AdamV3D/ble_stepper_motor_analyser/kicad/stepper_monitor.kicad_pcb

## KiCad design kicad/stepper_monitor.kicad_pcb (2025-02-03)

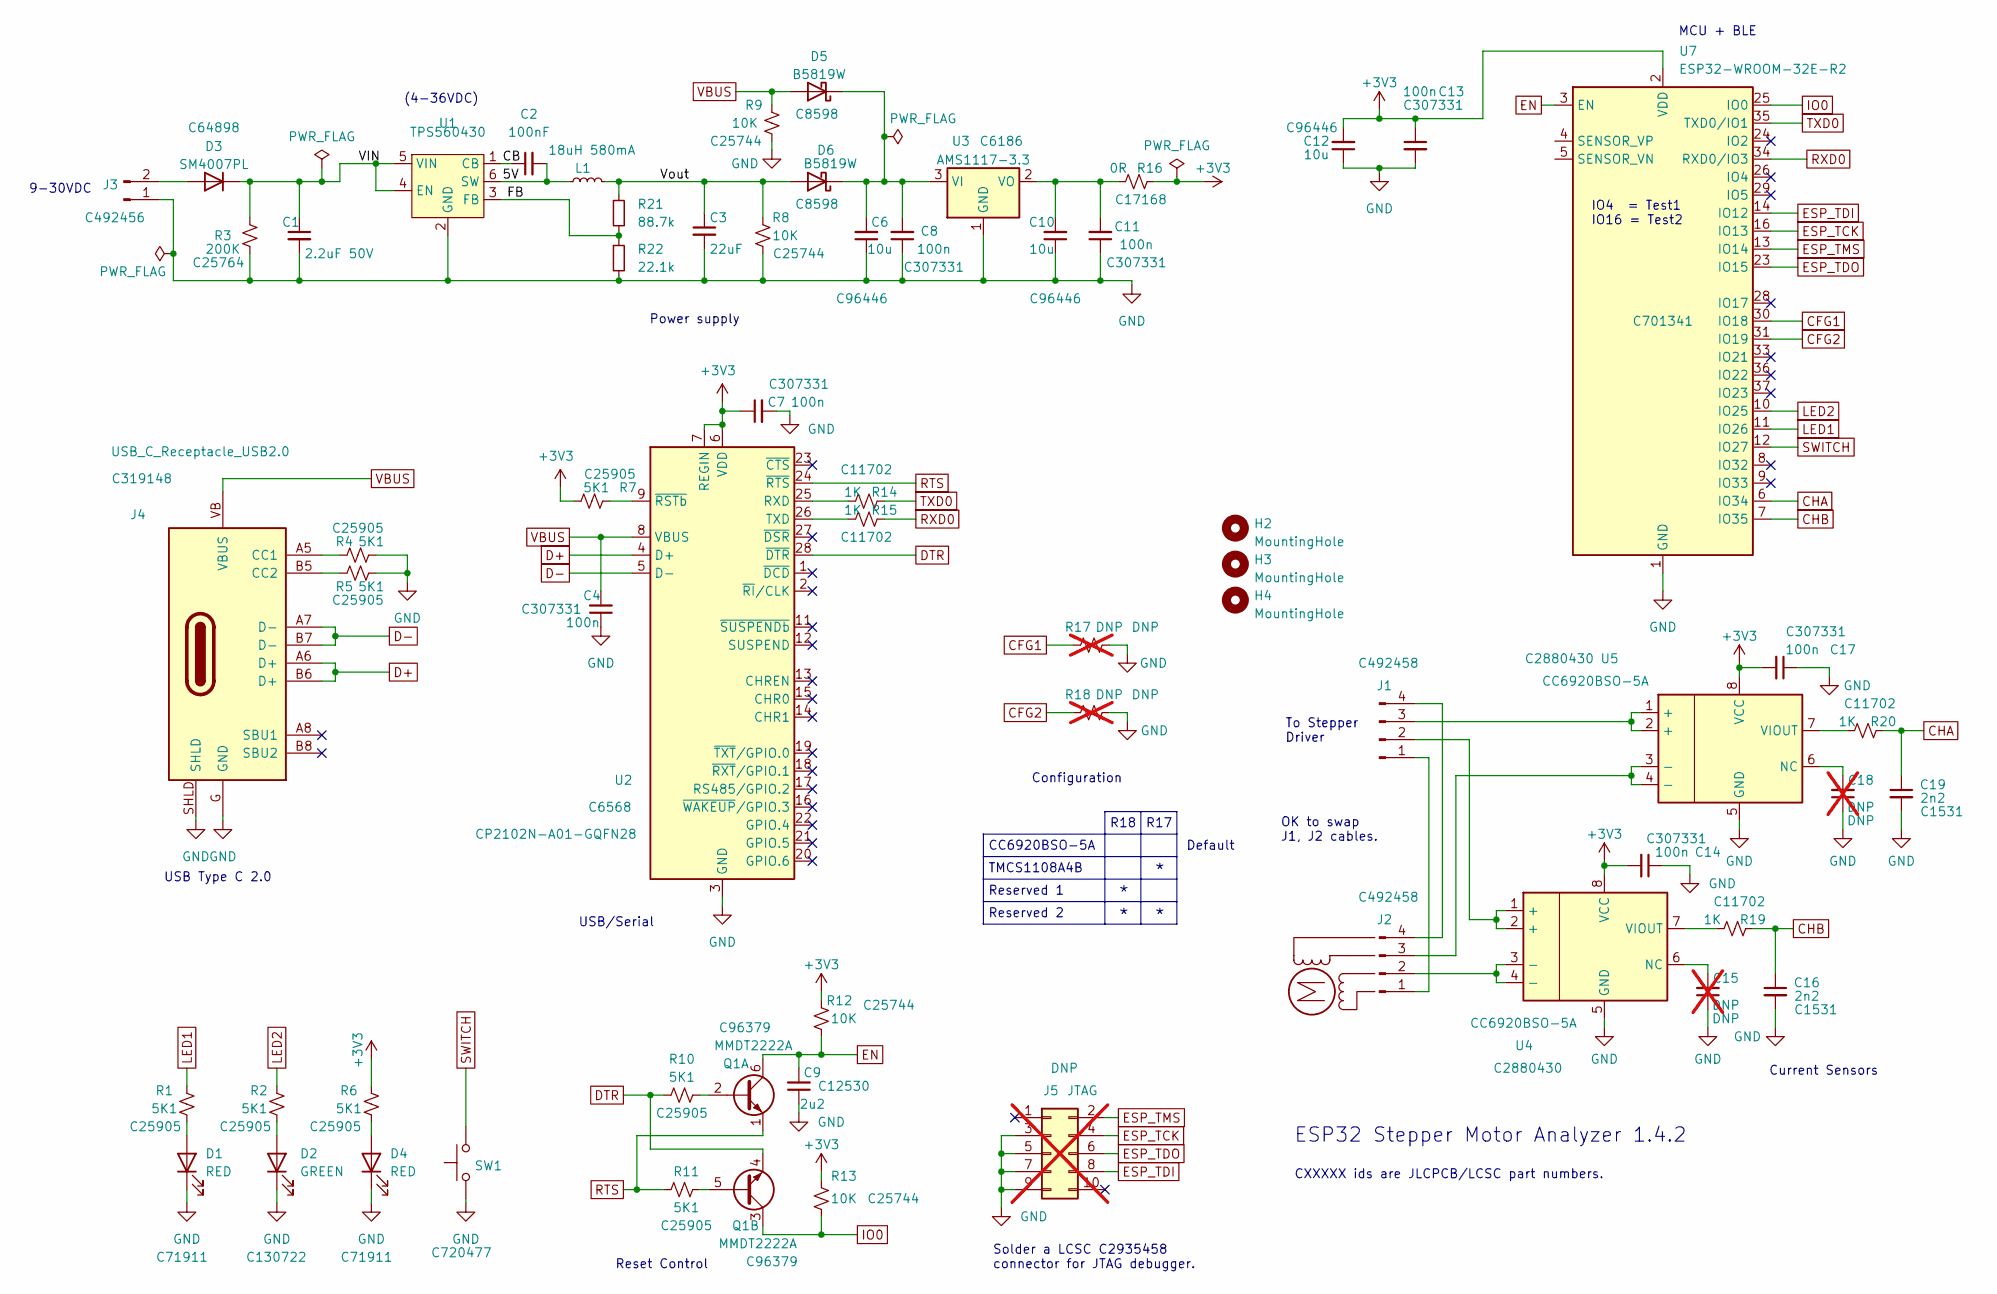
[picture p1: schematic stepper_monitor.kicad_sch]

Parts:
C1: 2.2uF 50V; C_0603_1608Metric; LCSC C913904
C2: 100nF; C_0402_1005Metric; LCSC C1525
C3: 22uF; C_0603_1608Metric; LCSC C86295
C4, C7, C8, C11, C13, C14, C17: 100n; C_0402_1005Metric; LCSC C307331
C6, C10, C12: 10u; C_0603_1608Metric; LCSC C96446
C9: 2u2; C_0402_1005Metric; LCSC C12530
C15, C18: DNP; C_0402_1005Metric; LCSC DNP; not fitted
C16, C19: 2n2; C_0402_1005Metric; LCSC C1531
D1, D4: RED; LED_0402_1005Metric_Pad0.77x0.64mm_HandSolder; LCSC C71911
D2: GREEN; LED_0402_1005Metric_Pad0.77x0.64mm_HandSolder; LCSC C130722
D3: SM4007PL; D2_SOD-123; LCSC C64898
D5, D6: B5819W; D_SOD-123; LCSC C8598
H2, H3, H4: MountingHole; MountingHole_3.2mm_M3_Pad_Via
J1, J2: Conn_01x04_Pin; JST_XH_B4B-XH-A_1x04_P2.50mm_Vertical; LCSC C492458
J3: Conn_01x02_Pin; JST_XH_B2B-XH-A_1x02_P2.50mm_Vertical; LCSC C492456
J4: USB_C_Receptacle_USB2.0; USB_C_Receptacle_XKB_U262-16XN-4BVC11; LCSC C319148
J5: JTAG; PinHeader_2x05_P1.27mm_Vertical_SMD; LCSC DNP; not fitted
L1: 18uH 580mA; L_Sunlord_SWPA3012S; LCSC C96833
M1: Motor-simple_stepper_motor_analyzer; Empty
Q1: MMDT2222A; SOT-363_SC-70-6; LCSC C96379
R1, R2, R4, R5, R6, R7, R10, R11: 5K1; R_0402_1005Metric; LCSC C25905
R3: 200K; R_0402_1005Metric; LCSC C25764
R8, R9, R12, R13: 10K; R_0402_1005Metric; LCSC C25744
R14, R15, R19, R20: 1K; R_0402_1005Metric; LCSC C11702
R16: 0R; R_0402_1005Metric; LCSC C17168
R17, R18: DNP; R_0402_1005Metric; LCSC DNP; not fitted
R21: 88.7k; R_0603_1608Metric; LCSC C23258
R22: 22.1k; R_0603_1608Metric; LCSC C25961
SW1: SW_Push; SW_Push_SPST_NO_Alps_SKRK; LCSC C720477
U1: TPS560430; SOT-23-6; LCSC C2863641
U2: CP2102N-A01-GQFN28; QFN-28-1EP_5x5mm_P0.5mm_EP3.35x3.35mm; LCSC C6568
U3: AMS1117-3.3; SOT-223-3_TabPin2; LCSC C6186
U4, U5: CC6920BSO-5A; SOIC-8_3.9x4.9mm_P1.27mm; LCSC C2880430
U7: ESP32-WROOM-32E-R2; ESP32-WROOM-32D; LCSC C701341

Connections:
+3V3: C7.1, C12.2, C13.1, C14.2, C17.2, R6.2, R7.2, R12.2, R13.2, R16.1, U2.6 (VDD), U2.7 (REGIN), U4.8 (VCC), U5.8 (VCC), U7.2 (VDD)
/5V: C2.2, L1.1, U1.6 (SW)
/CB: C2.1, U1.1 (CB)
/FB: R21.2, R22.1, U1.3 (FB)
/VIN: C1.1, D3.1 (K), R3.1, U1.4 (EN), U1.5 (VIN)
/Vout: C3.1, D6.2 (A), L1.2, R8.2, R21.1
CFG1: R17.1, U7.30 (IO18)
CFG2: R18.1, U7.31 (IO19)
CHA: C19.1, R20.1, U7.6 (IO34)
CHB: C16.1, R19.1, U7.7 (IO35)
D+: J4.A6 (D+), J4.B6 (D+), U2.4 (D+)
D-: J4.A7 (D-), J4.B7 (D-), U2.5 (D-)
DTR: Q1.4 (E2), R10.1, U2.28 (~DTR)
EN: C9.2, Q1.6 (C1), R12.1, U7.3 (EN)
ESP_TCK: J5.4, U7.16 (IO13)
ESP_TDI: J5.8, U7.14 (IO12)
ESP_TDO: J5.6, U7.23 (IO15)
ESP_TMS: J5.2, U7.13 (IO14)
GND: C1.2, C3.2, C4.1, C6.1, C7.2, C8.1, C9.1, C10.1, C11.1, C12.1, C13.2, C14.1, C15.1, C16.2, C17.1, C18.1, C19.2, D1.1 (K), D2.1 (K), D4.1 (K), J3.1, J4.G (GND), J4.SHLD, J5.3, J5.5, J5.7, J5.9, R3.2, R4.1, R5.1, R8.1, R9.1, R17.2, R18.2, R22.2, SW1.1, U1.2 (GND), U2.3 (GND), U2.29 (GND), U3.1 (GND), U4.5 (GND), U5.5 (GND), U7.1 (GND), U7.15 (GND), U7.38 (GND), U7.39 (GND)
IO0: Q1.3 (C2), R13.1, U7.25 (IO0)
LED1: R1.2, U7.11 (IO26)
LED2: R2.2, U7.10 (IO25)
unnamed: D1.2 (A), R1.1
unnamed: D2.2 (A), R2.1
unnamed: D3.2 (A), J3.2
unnamed: D4.2 (A), R6.1
unnamed: C6.2, C8.2, D5.1 (K), D6.1 (K), U3.3 (VI)
unnamed: J1.1, J2.1
unnamed: J1.2, U4.1 (+), U4.2 (+)
unnamed: J1.3, U5.1 (+), U5.2 (+)
unnamed: J1.4, J2.4
unnamed: J2.2, U4.3 (-), U4.4 (-)
unnamed: J2.3, U5.3 (-), U5.4 (-)
unnamed: J4.A5 (CC1), R4.2
unnamed: J4.B5 (CC2), R5.2
unnamed: Q1.2 (B1), R10.2
unnamed: Q1.5 (B2), R11.1
unnamed: R14.2, U2.25 (RXD)
unnamed: R15.2, U2.26 (TXD)
unnamed: R7.1, U2.9 (~RSTb)
unnamed: C10.2, C11.2, R16.2, U3.2 (VO)
unnamed: C15.2, U4.6 (NC)
unnamed: R19.2, U4.7 (VIOUT)
unnamed: C18.2, U5.6 (NC)
unnamed: R20.2, U5.7 (VIOUT)
RTS: Q1.1 (E1), R11.2, U2.24 (~RTS)
RXD0: R15.1, U7.34 (RXD0/IO3)
SWITCH: SW1.2, U7.12 (IO27)
TXD0: R14.1, U7.35 (TXD0/IO1)
VBUS: C4.2, D5.2 (A), J4.VB (VBUS), R9.2, U2.8 (VBUS)

Notes on the sheet:
Solder a LCSC C2935458 connector for JTAG debugger.
TMCS1108A4B
Current Sensors
Reserved 2
IO4 = Test1 IO16 = Test2
CXXXXX ids are JLCPCB/LCSC part numbers.
Reserved 1
To Stepper Driver
Configuration
USB Type C 2.0
9-30VDC
USB/Serial
OK to swap J1, J2 cables.
Reset Control
Default
R17
CC6920BSO-5A
R18
MCU + BLE
(4-36VDC)
Power supply
ESP32 Stepper Motor Analyzer 1.4.2

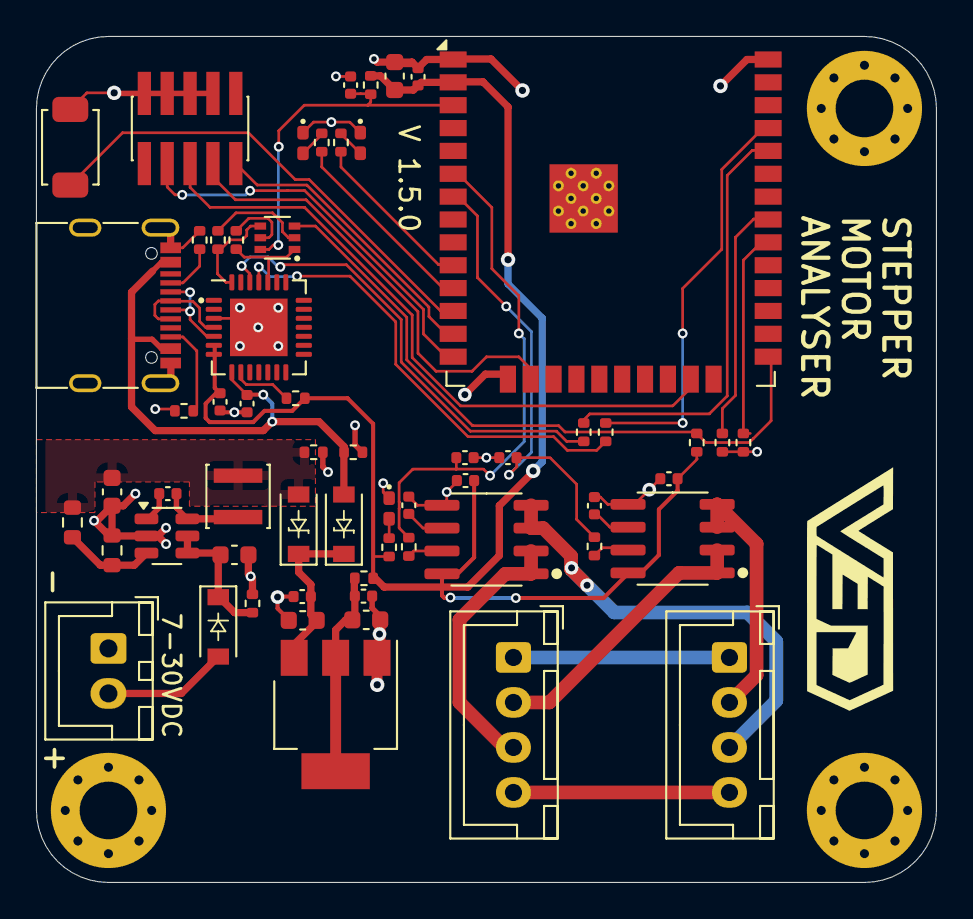
[picture p2: board stepper_monitor.kicad_pcb from above]

Board: 2 copper layers, 50.0 x 47.0 mm, 63 parts (0 on the bottom side), 50 nets.
