AdamV3D/ble_stepper_motor_analyser/(commit log)

2025-01-25 New version without Mornsun regulator
    [BOM-stepper_monitor.csv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]
2025-02-03 Fixed R2 and regen BOM
    [BOM-stepper_monitor.csv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]
